bbokser/hopper-power-dist/hopper-power-dist-bom.xlsx

Component Count: | 27
Ref | QTY | Value | Cmp name | Footprint | Description | Vendor | Source
C2, | 1 | 4.7microF | C | SamacSys_Parts:CAPC3225X270N | Unpolarized capacitor 100V | Mouser | https://www.mouser.com/ProductDetail/Taiyo-Yuden/HMK325C7475KM-PE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
C3, | 1 | 4.7microF | C | Capacitor_SMD:C_0805_2012Metric | Unpolarized capacitor 50V | Mouser | https://www.mouser.com/ProductDetail/Murata-Electronics/GRT21BC71H475KE13L?qs=rI7uf1IzohQrtwc9u30k7A%3D%3D
C4, C5, | 2 | 1000pF | C | Capacitor_SMD:C_1206_3216Metric | Unpolarized capacitor | Mouser | https://www.mouser.com/ProductDetail/KEMET/C1812X102JGGACAUTO?qs=DuoOggApuK%2FRLf5DgtkU5Q%3D%3D
C6, | 1 | 470pF | C | Capacitor_SMD:C_1206_3216Metric | Unpolarized capacitor | Mouser | https://www.mouser.com/ProductDetail/Kyocera-AVX/1206GC471MAT1A?qs=5vZCdhuZeNMtI7Rici6%2FPw%3D%3D
D1, | 1 | AK3-066C-Y | AK3-066C-Y | SamacSys_Parts:AK3066CY | TVS Diode Bi-Dir 66V 72V Breakdown Thru-Hole | Mouser | https://www.mouser.com/ProductDetail/Littelfuse/AK3-066C-Y?qs=P1JMDcb91o7SsHSLqUW48g%3D%3D
D2, | 1 | SMDJ17A | SMDJ17A | DIOM7959X262N | TVS Diode Single Uni-Dir 17V 3KW 2-Pin SMC T/R | Mouser | https://www.mouser.com/ProductDetail/Littelfuse/SMDJ17A?qs=zL8PTTxXkF3xEULSfYm2Bw%3D%3D
D3, | 1 | LED | LED | LED_SMD:LED_0603_1608Metric | Light emitting diode | Mouser | https://www.mouser.com/ProductDetail/ams-OSRAM/KW-DELSS2.RA-AXBZ-FK0PM0-2686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
F1, | 1 | SF-1206S1000W-2 | SF-1206S1000W-2 | FUSC3216X123N | BOURNS - SF-1206S1000W-2 - Fuse, Surface Mount, Wire Core, 10 A, SinglFuse SF-1206SxxxW Series, 32 V, Slow Blow, 1206 | Mouser | https://www.mouser.com/ProductDetail/Bourns/SF-1206S1000W-2?qs=fAHHVMwC%252BbilUMcZCwppRg%3D%3D
H1, | 1 | B- | MountingHole_Pad | MountingHole:MountingHole_4.3mm_M4_Pad_Via | Mounting Hole with connection
H2, | 1 | C- | MountingHole_Pad | MountingHole:MountingHole_4.3mm_M4_Pad_Via | Mounting Hole with connection
J1, J2, | 2 | XT60PW-M | XT60PW-M | XT60PW-F:AMASS_XT60PW-M | XT60-PW Connector (Male) | Amazon
J3, J4, | 2 | B2B-XH-A(LF)(SN) | B2B-XH-A(LF)(SN) | JST_B2B-XH-A(LF)(SN) | JST 2-Pin Connector | Amazon
J5, | 1 | XT60-F | XT60-F | XT60PW-F:AMASS_XT60-F | XT60 Connector | Amazon
J6, J7, J8, J9, | 4 | XT60PW-F | XT60PW-F_2 | AMASS_XT60PW-F | XT60-PW Connector (Female) | Amazon
L1, L2, | 2 | 12microF | L | SamacSys_Parts:LPS6235123MRC | Inductor | Mouser | https://www.mouser.com/ProductDetail/Coilcraft/LPS6235-123MRC?qs=QQJxVsr8EGbU8FJCBNNVCA%3D%3D
PS1, | 1 | JTL6048S15 | JTL6048S15 | JTL6048S15 | XP POWER - JTL6048S15 - DC-DC CONVERTER, 15V, 4A | Mouser | https://www.mouser.com/ProductDetail/XP-Power/JTL6048S15?qs=w%2Fv1CP2dgqpuhtR6ox8pSA%3D%3D
R1, | 1 | 360 Ohm | R | benbokser:AC03000003600JAC00 | Resistor | Mouser | https://www.mouser.com/ProductDetail/Vishay-Draloric/AC03000003600JAC00
R2, | 1 | 22k Ohm | R | Resistor_SMD:R_0603_1608Metric_Pad0.98x0.95mm_HandSolder | Resistor | Mouser | https://www.mouser.com/ProductDetail/Panasonic/ERJ-UP3J223V?qs=GedFDFLaBXHkpI8RZhFc4A%3D%3D
S1, | 1 | 2MS6T1B3M2QES | 2MS6T1B3M2QES | 2MS6T1B3M2QES | Toggle Switches SPST OFF-ON | Mouser | https://www.mouser.com/ProductDetail/Dailywell/2MS6T1B3M2QES?qs=B6kkDfuK7%2FCLnLIcqzvQEQ%3D%3D
SW1, | 1 | FT_Power_Switch | FT_Power_Switch | benbokser:FT Power Switch | High-Current Mechanical Switch | Mouser | https://www.fingertechrobotics.com/proddetail.php?prod=ft-mini-switch
 |  |  |  |  | (CONNECTS TO J3, NOT SHOWN ON SCHEMATIC/BOARD) | Amazon | https://www.amazon.com/MXRS-Hinge-Momentary-Button-Switch/dp/B07MW2RPJY/ref=lp_5739467011_1_1
