bbokser/hopper-power-dist/hopper-power-dist.step

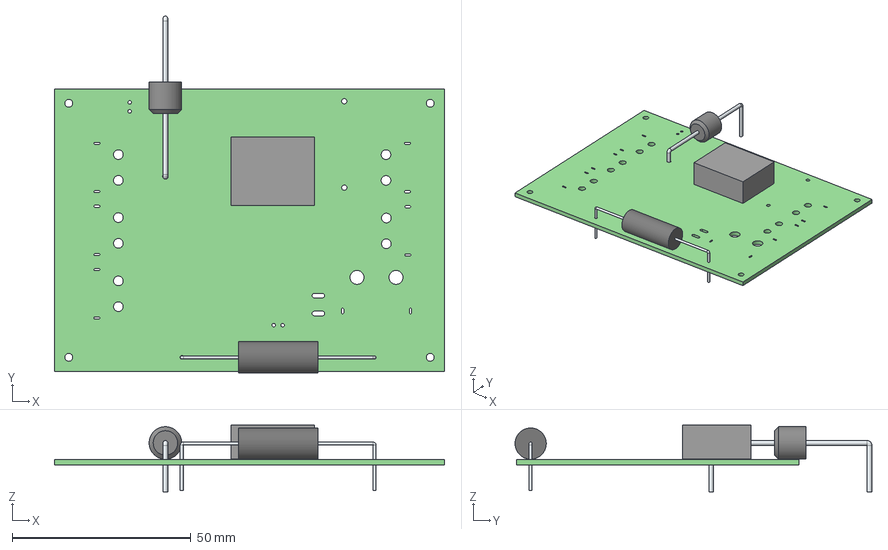
[picture p1: CAD file, 2022-07-18]
hopper-power-dist.step
109.0 x 99.8 x 18.6 mm
hopper-power-dist PCB
