bbokser/hopper-power-dist/hopper-power-dist.kicad_pcb

## KiCad design hopper-power-dist.kicad_pcb (2022-08-29)

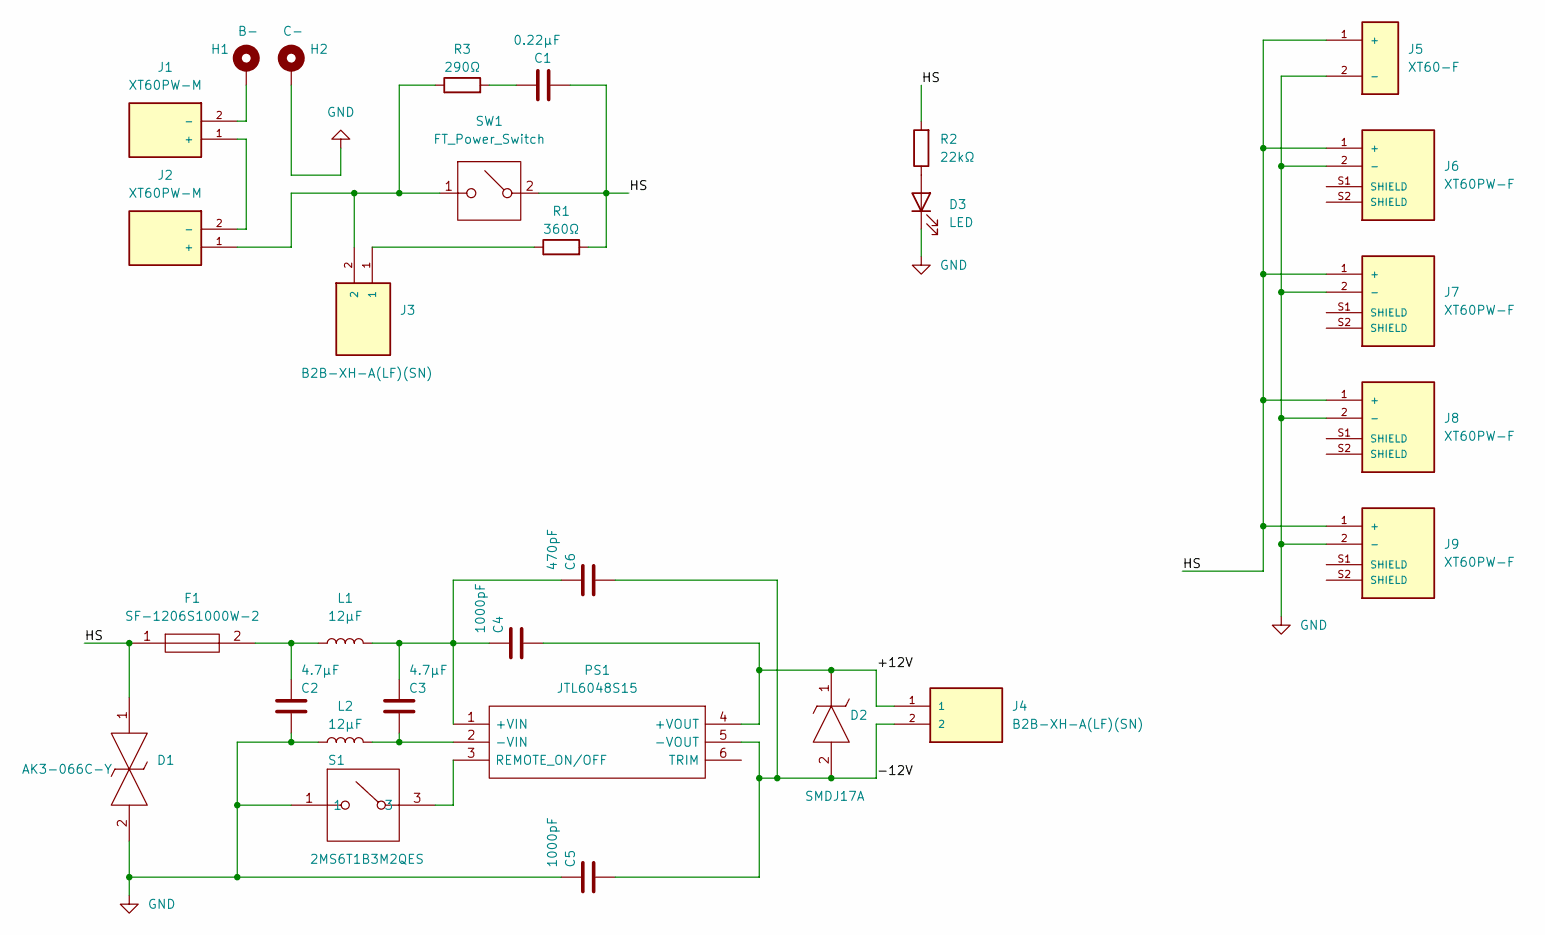
[picture p2: schematic hopper-power-dist.kicad_sch]

Parts:
C1: 0.22μF; C_1206_3216Metric
C2: 4.7μF; CAPC3225X270N
C3: 4.7μF; C_0805_2012Metric
C4, C5: 1000pF; C_1206_3216Metric
C6: 470pF; C_1206_3216Metric
D1: AK3-066C-Y; AK3066CY; Mouser Part Number 576-AK3-066C-Y
D2: SMDJ17A; DIOM7959X262N; Manufacturer_Part_Number SMDJ17A
D3: LED; LED_0603_1608Metric
F1: SF-1206S1000W-2; FUSC3216X123N; Mouser Part Number 652-SF-1206S1000W-2
H1: B-; MountingHole_4.3mm_M4_Pad_Via
H2: C-; MountingHole_4.3mm_M4_Pad_Via
J1, J2: XT60PW-M; AMASS_XT60PW-M; PARTREV V1.2
J3, J4: B2B-XH-A(LF)(SN); JST_B2B-XH-A(LF)(SN)
J5: XT60-F; AMASS_XT60-F; PARTREV 1.2
J6, J7, J8, J9: XT60PW-F; AMASS_XT60PW-F; PARTREV V1.2
L1, L2: 12μF; LPS6235123MRC
PS1: JTL6048S15; Mouser Part Number 209-JTL6048S15
R1: 360Ω; AC03000003600JAC00
R2: 22kΩ; R_0603_1608Metric_Pad0.98x0.95mm_HandSolder
R3: 290Ω; R_2512_6332Metric
S1: 2MS6T1B3M2QES; Mouser Part Number 118-2MS6T1B3M2QES
SW1: FT_Power_Switch; FT Power Switch

Connections:
/+12V: C4.2, D2.1, J4.1, PS1.4 (+VOUT)
/-12V: C5.2, C6.2, D2.2, J4.2, PS1.5 (-VOUT)
/HS: C1.2, D1.1, F1.1, J5.1 (+), J6.1 (+), J7.1 (+), J8.1 (+), J9.1 (+), R1.2, R2.2, SW1.2
GND: C2.2, C5.1, D1.2, D3.1 (K), H2.1, J5.2 (-), J6.2 (-), J7.2 (-), J8.2 (-), J9.2 (-), L2.1, S1.1
unnamed: C1.1, R3.2
unnamed: C2.1, F1.2, L1.1
unnamed: C3.1, C4.1, C6.1, L1.2, PS1.1 (+VIN)
unnamed: C3.2, L2.2, PS1.2 (-VIN)
unnamed: D3.2 (A), R2.1
unnamed: H1.1, J1.2 (-)
unnamed: J1.1 (+), J2.2 (-)
unnamed: J2.1 (+), J3.2, R3.1, SW1.1
unnamed: J3.1, R1.1
unnamed: PS1.3 (REMOTE_ON/OFF), S1.3

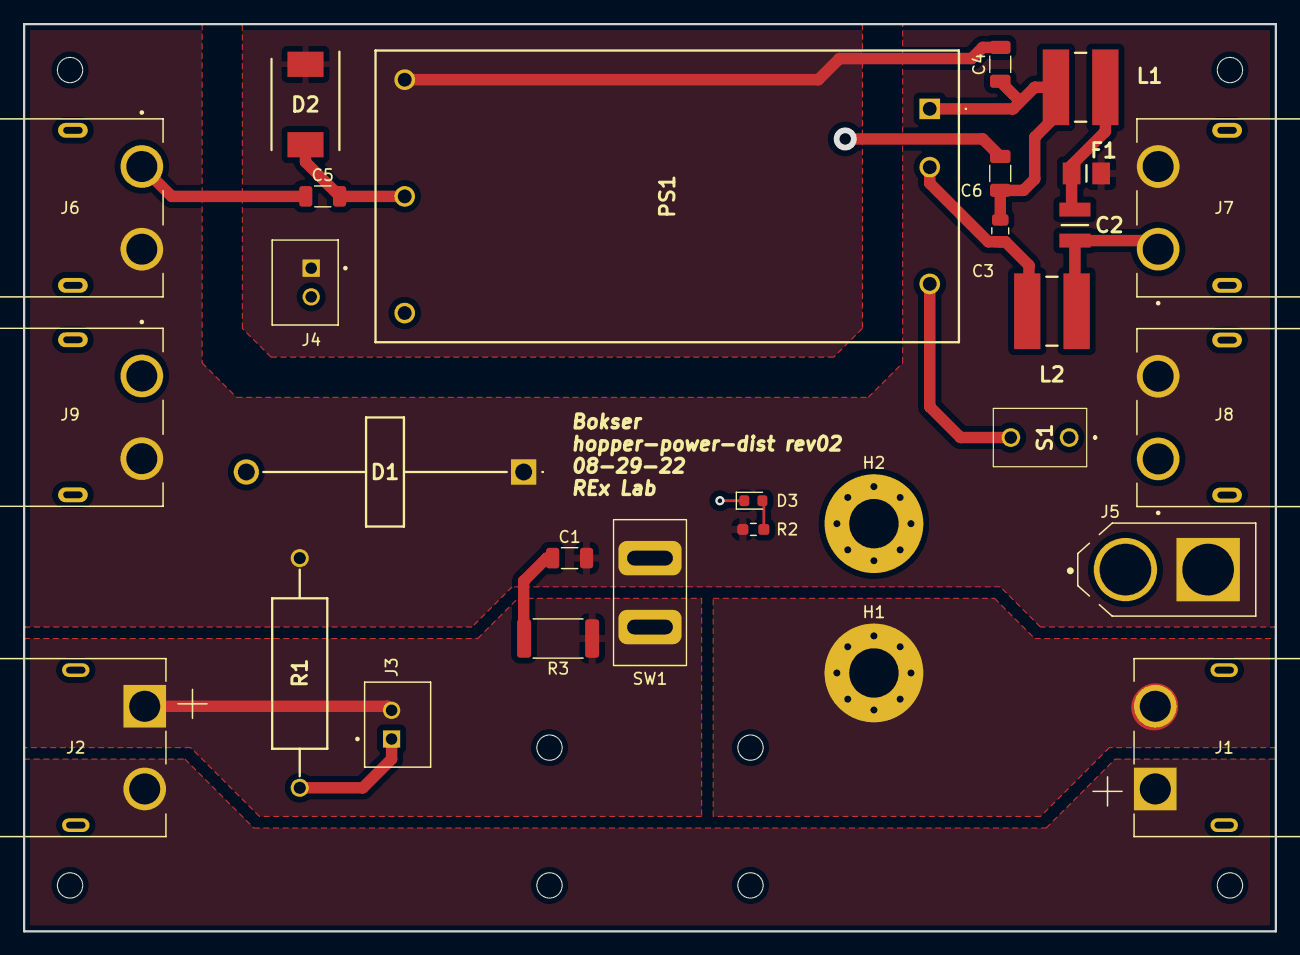
[picture p3: board hopper-power-dist.kicad_pcb from above]

Board: 2 copper layers, 109.0 x 79.0 mm, 30 parts (0 on the bottom side), 14 nets.

Other parts of the board:
REF: MountingHole_2.2mm_M2
