bbokser/hopper-power-dist/(commit log)

2022-07-13 Create schematic
    [hopper-power-dist-bom.xlsx, hopper-power-dist.kicad_pcb, hopper-power-dist.kicad_sch]
2022-07-15 Initialize PCB, update gitignore
    [hopper-power-dist.kicad_pcb, hopper-power-dist.kicad_sch]
2022-07-17 Create basic PCB layout
    [hopper-power-dist.kicad_pcb, hopper-power-dist.kicad_sch]
2022-07-17 Update BoM
    [hopper-power-dist-bom.xlsx, hopper-power-dist.kicad_sch]
2022-07-18 Fix schematic and update 3d models
    [hopper-power-dist-bom.xlsx, hopper-power-dist.kicad_pcb, hopper-power-dist.kicad_sch, hopper-power-dist.step]
2022-07-20 Changed precharge resistor, routed PCB traces and updated 3D models
    [hopper-power-dist.kicad_pcb, hopper-power-dist.kicad_sch]
2022-07-24 Improved PCB design and completed DRC
    [hopper-power-dist-bom.xlsx, hopper-power-dist.kicad_pcb]
2022-07-25 Moved BEC JST connector to be more accessible
    [hopper-power-dist.kicad_pcb]
2022-08-21 Start rev02, fix minor mistakes and add xt60pw-m series
    [hopper-power-dist.kicad_pcb, hopper-power-dist.kicad_sch]
2022-08-21 Replace DC-DC converter with thru-hole version and clean up
    [hopper-power-dist-bom.xlsx, hopper-power-dist.kicad_pcb, hopper-power-dist.kicad_sch]
2022-08-23 Replaced DC-DC Converter and working on capacitor selection
    [hopper-power-dist-bom.xlsx, hopper-power-dist.kicad_pcb, hopper-power-dist.kicad_sch]
2022-08-23 Further tweaks to v2 design
    [hopper-power-dist-bom.xlsx, hopper-power-dist.kicad_pcb, hopper-power-dist.kicad_sch]
2022-08-29 Minor improvements made
    [hopper-power-dist.kicad_pcb]
2022-08-29 Added spark suppression and changed thermal reliefs to solid on high power pads
    [hopper-power-dist.kicad_pcb, hopper-power-dist.kicad_sch]
